ZouQiangBin/POV-LED/POV LED (1).jpg

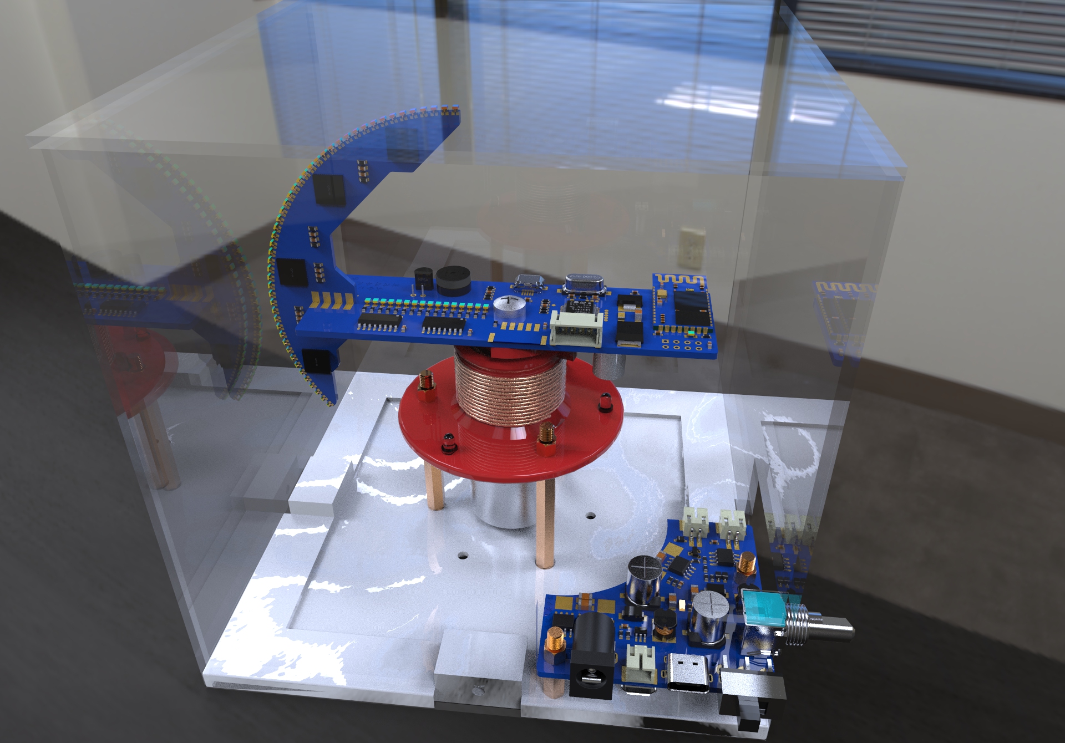
POV LED (1).jpg
