ZouQiangBin/POV-LED/1-DATASHEET/插座-LIGHTING2-苹果.jpg

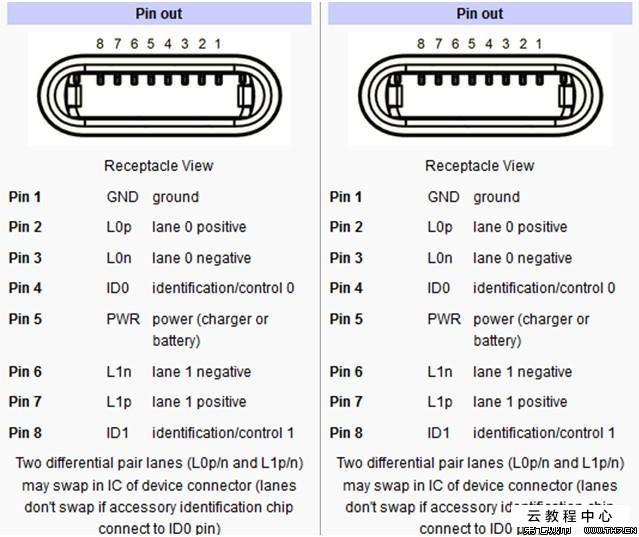
1-DATASHEET/插座-LIGHTING2-苹果.jpg
