ZouQiangBin/POV-LED/README.md

# POV-LED
一个有意思的LED项目
POV LED (1)
