ZouQiangBin/POV-LED/0-SCH&PCB&3D/ReadMe.txt

.sch和.pcb文件请使用PADS VX2.4或更高版本打开，结构文件请用中望3D 2020或更高版本打开
