ZouQiangBin/POV-LED/3-FIRMWARE/Project-MBI5353-SK9822/User/ReadMe.txt

作者：我就是头驴
时间：2022.3.13

整个项目包括：
1.用户IO：保留
2.SPI1、SPI2：LED控制
3.ADC1：采集无线供电电源电压、5V电压
4.USART2：BLE蓝牙串口
5.TIM1：灰度时钟
6.TIM2：速度测量
7.TIM3：蜂鸣器控制
8.TIM4：所有LED刷新
9.贪吃蛇功能
10.图片播放-暂未实现弧形界面纠正
11.音乐播放
