ZouQiangBin/POV-LED/1-DATASHEET/蓝牙模块-ECB02/4.硬件参考资料/ECB01硬件参考设计/说明.txt

ECB01-Kit-001.PcbDoc   贴片天线
ECB01-Kit-002.PcbDoc   PCB天线
ECB01-Kit-003.PcbDoc   IPEX一代天线连接器
ECB01-Kit-004.PcbDoc   IPEX三代天线连接器
ECB01-Kit-005.PcbDoc   SMA天线连接器
