ZouQiangBin/POV-LED/5-论文及资料/基于POV的两类旋转LED屏的研究与实现.pdf

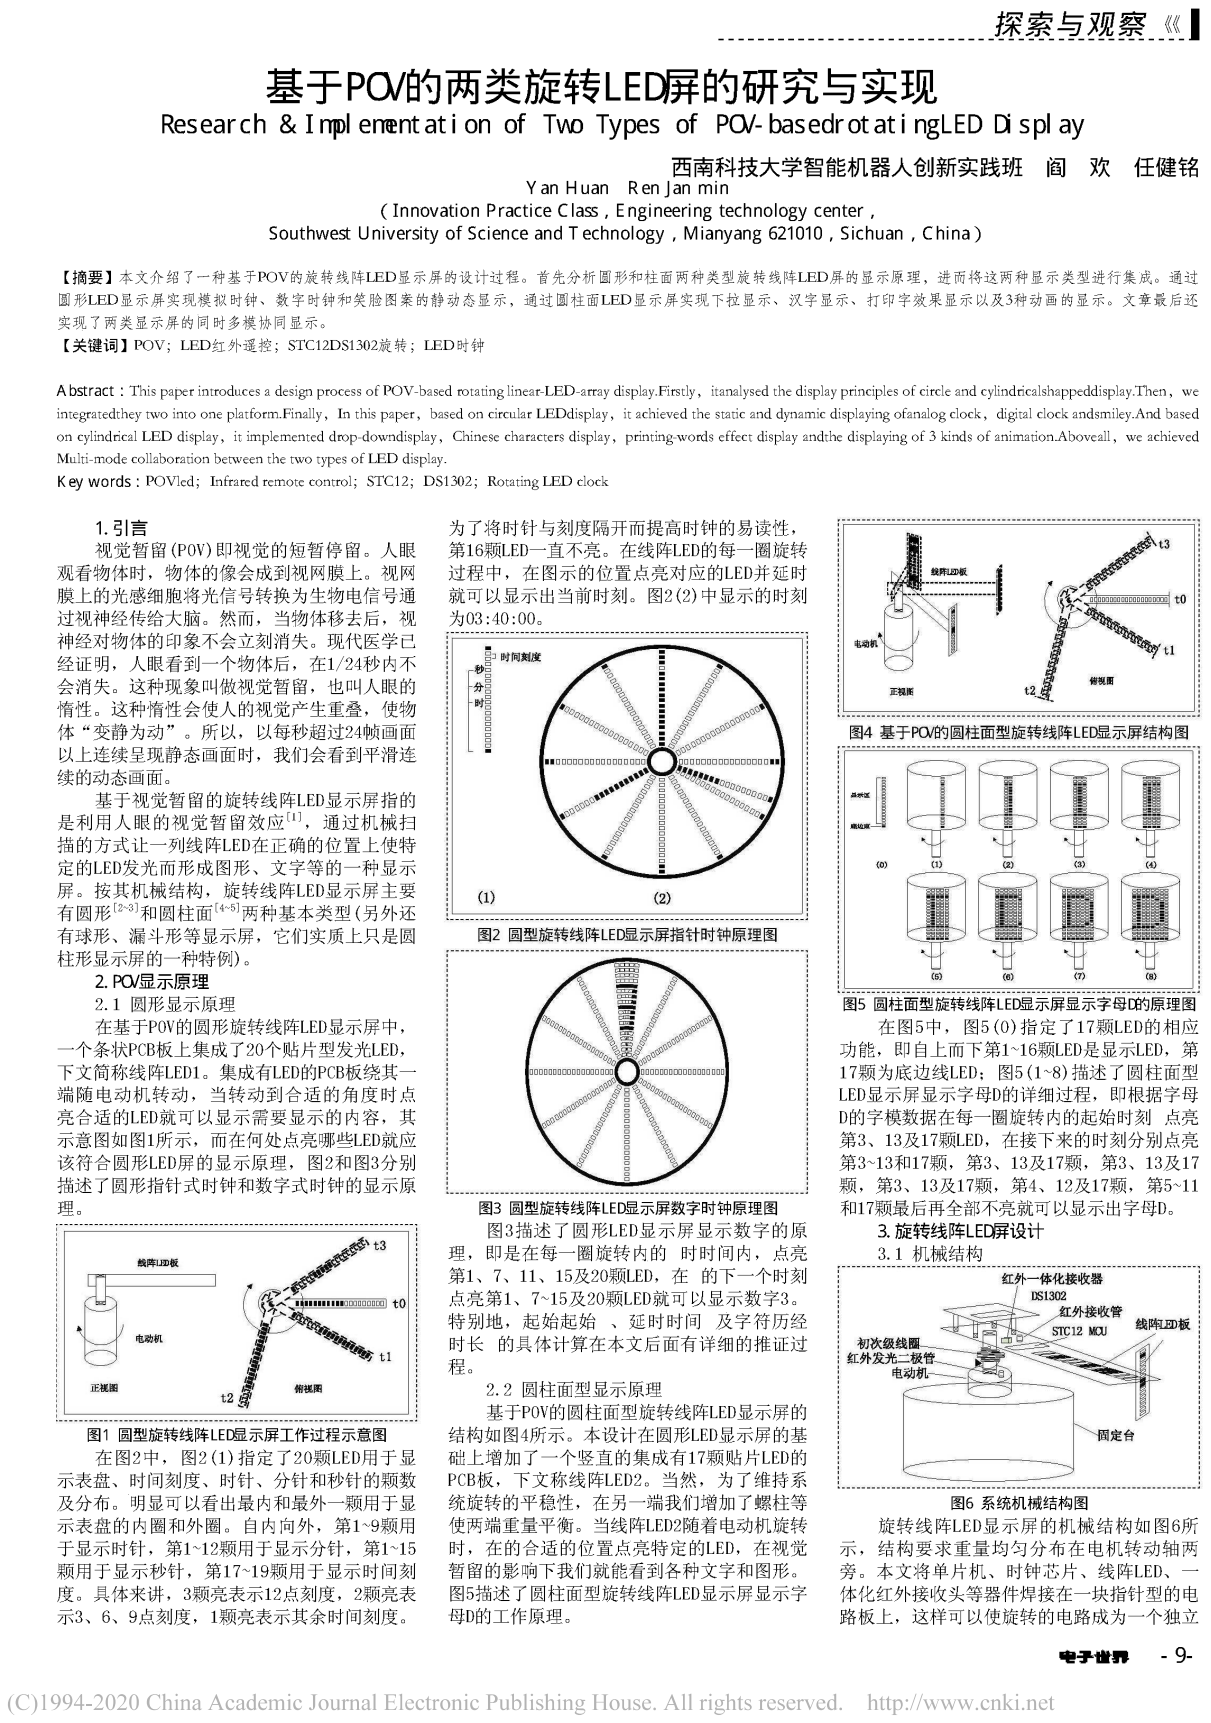
[picture p13: page 1]

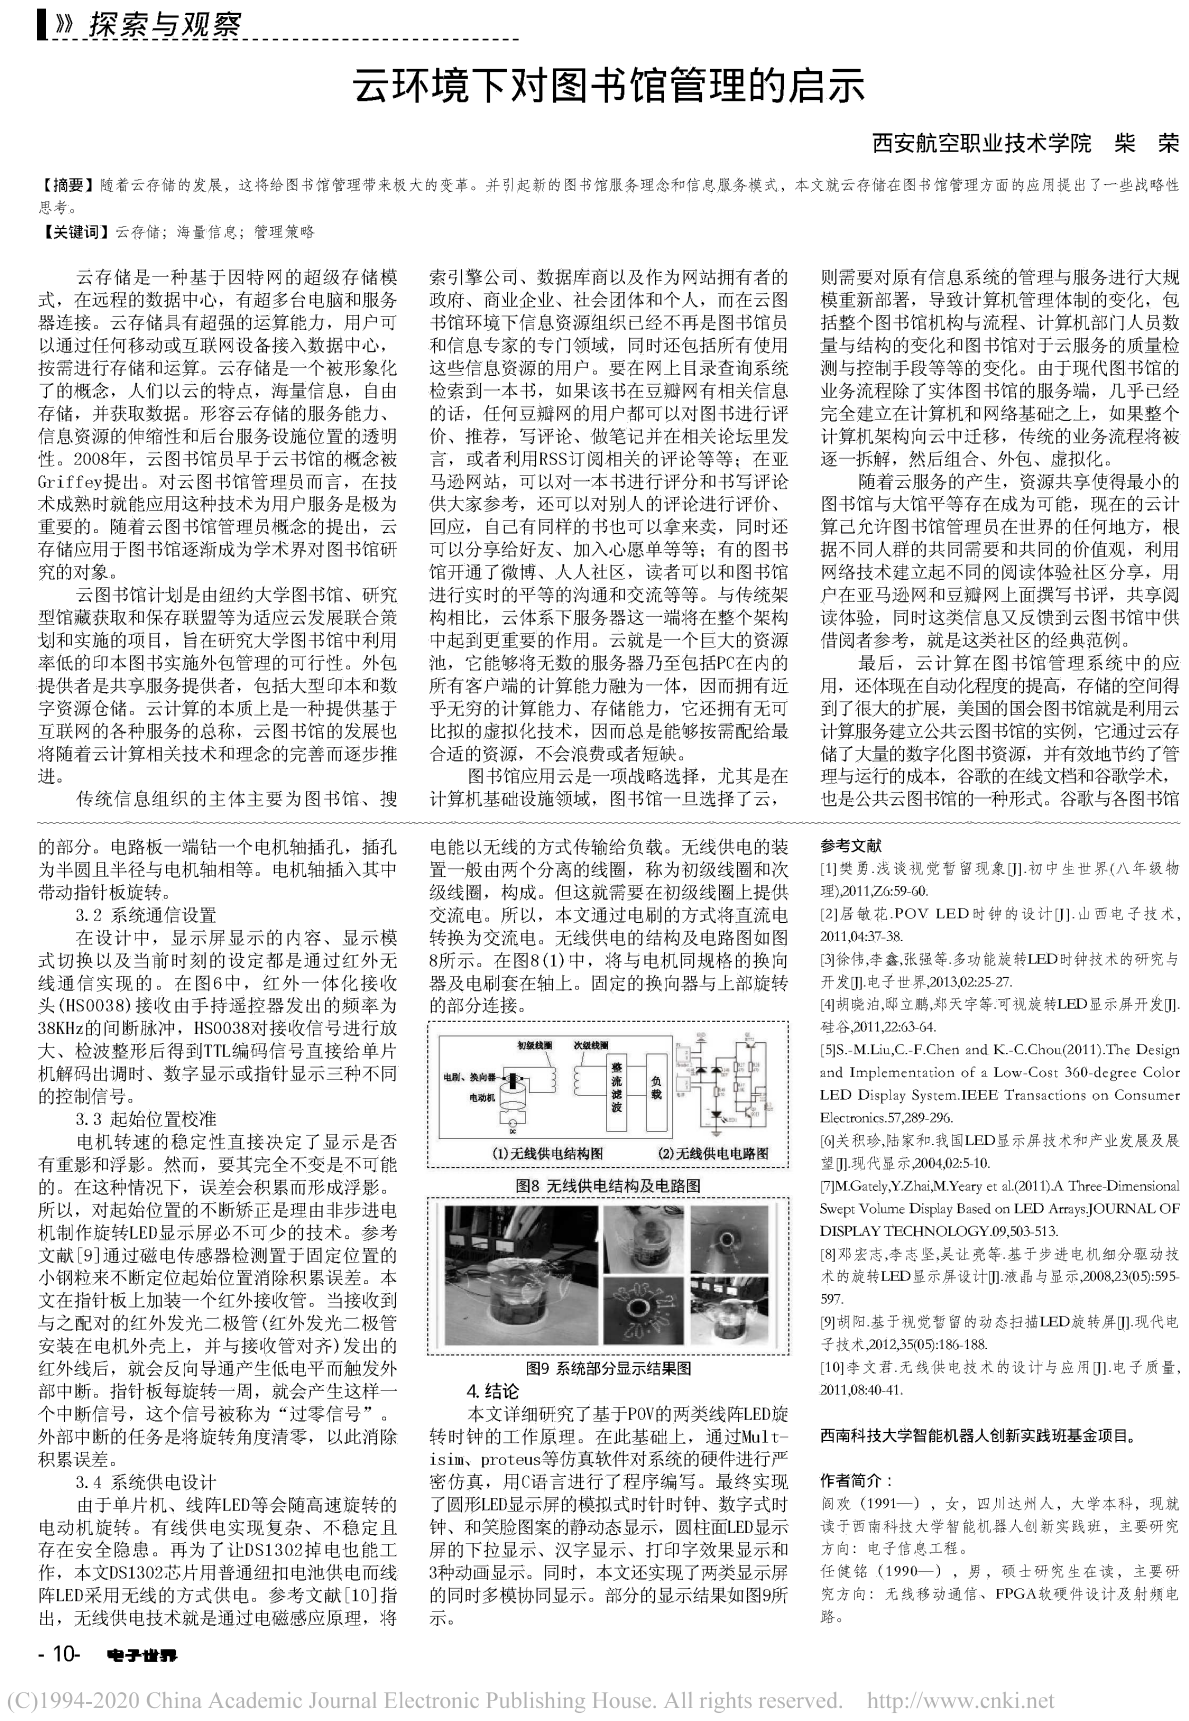
[picture p14: page 2]
