ZouQiangBin/POV-LED/1-DATASHEET/LED灯珠-0603.png

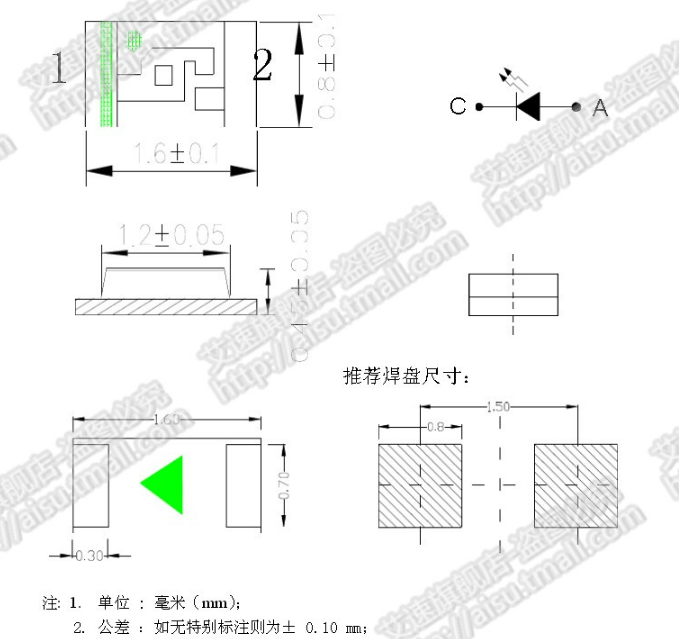
1-DATASHEET/LED灯珠-0603.png
