ZouQiangBin/POV-LED/1-DATASHEET/LED灯珠-0805-RGB-2012封装.PNG

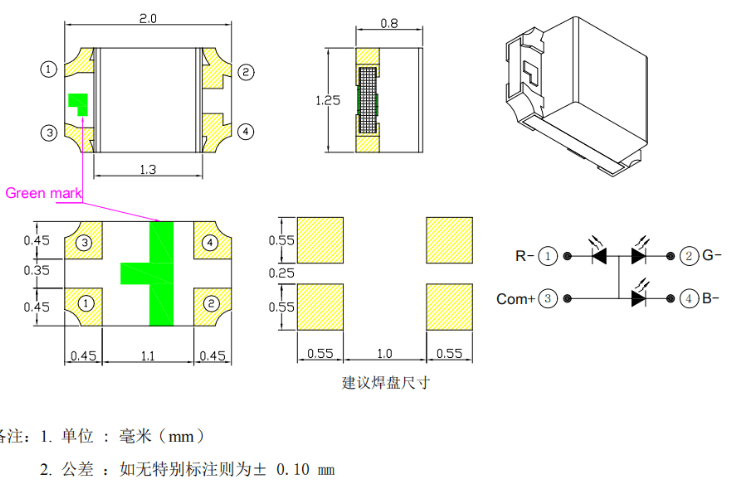
1-DATASHEET/LED灯珠-0805-RGB-2012封装.PNG
