ZouQiangBin/POV-LED/1-DATASHEET/LED灯珠-0805.png

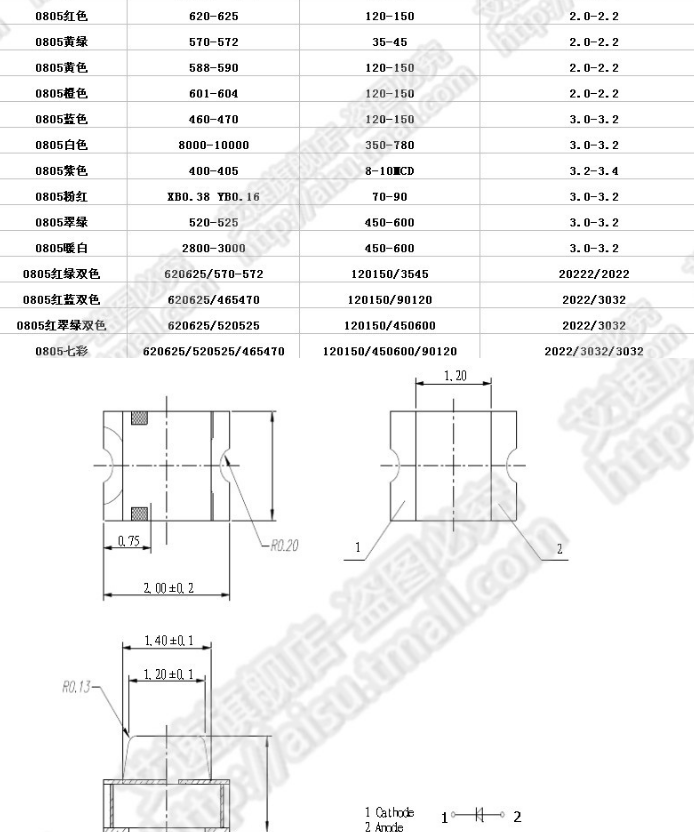
1-DATASHEET/LED灯珠-0805.png
