ZouQiangBin/POV-LED/1-DATASHEET/开关-5x5x1.5-贴片.png

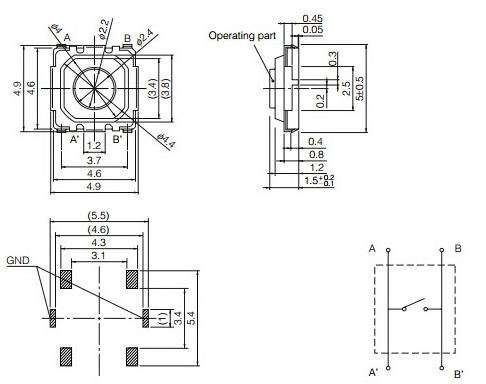
1-DATASHEET/开关-5x5x1.5-贴片.png
