ZouQiangBin/POV-LED/1-DATASHEET/开关-SS12D06.PNG

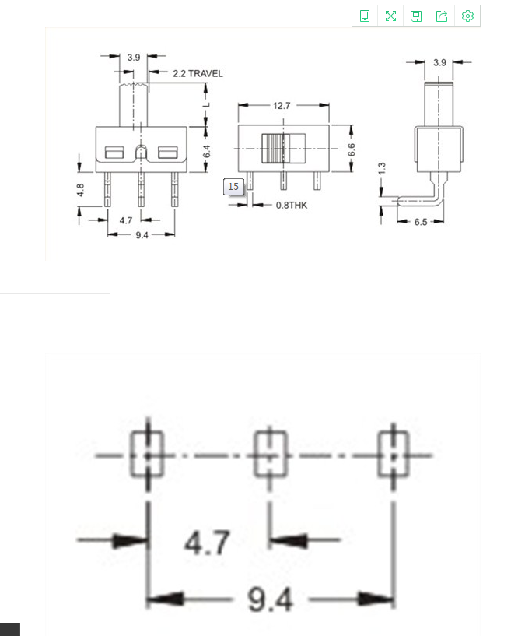
1-DATASHEET/开关-SS12D06.PNG
