ZouQiangBin/POV-LED/1-DATASHEET/插座-DC-005-电源接口.PNG

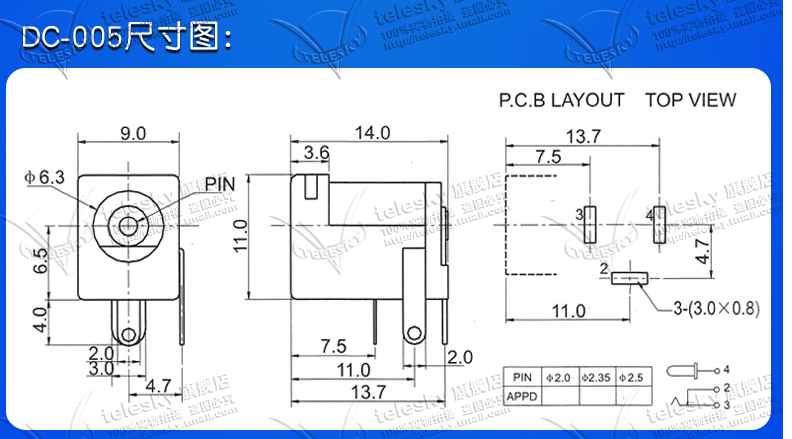
1-DATASHEET/插座-DC-005-电源接口.PNG
