ZouQiangBin/POV-LED/1-DATASHEET/插座-PH2.0卧式贴片.PNG

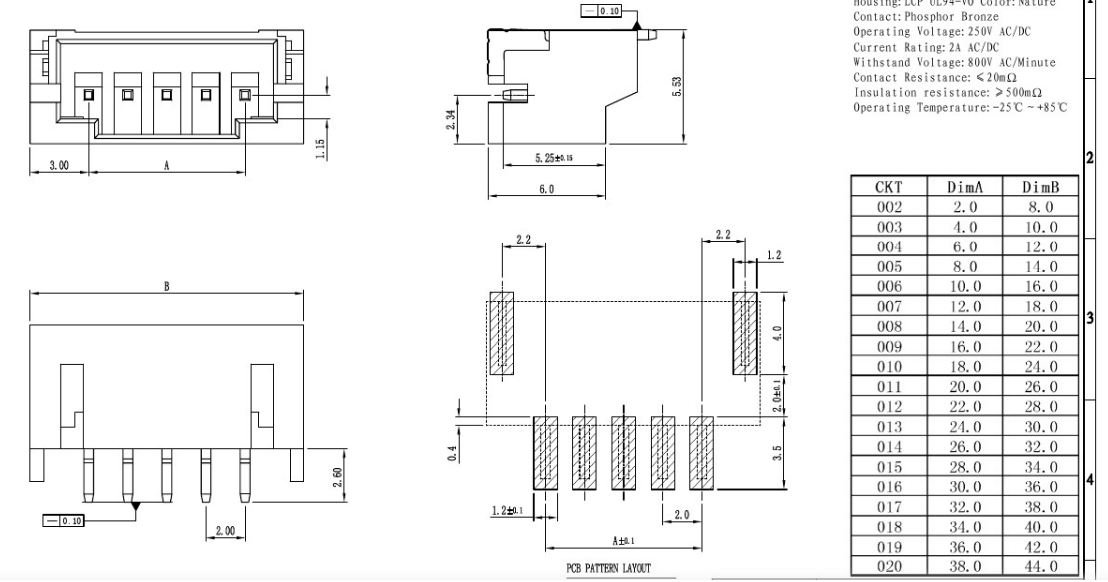
1-DATASHEET/插座-PH2.0卧式贴片.PNG
