ZouQiangBin/POV-LED/1-DATASHEET/插座-USB-TYPEC-6P.PNG

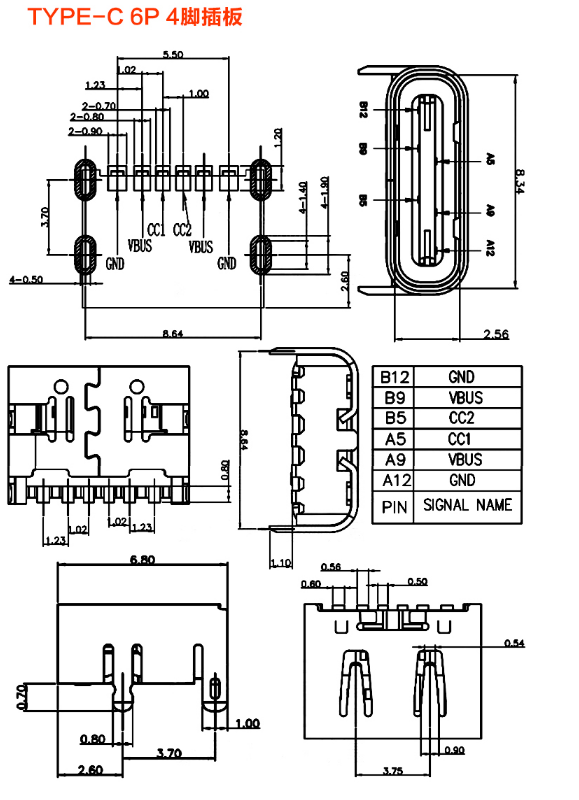
1-DATASHEET/插座-USB-TYPEC-6P.PNG
