ZouQiangBin/POV-LED/1-DATASHEET/插座-USBA-4P-侧插.jpg

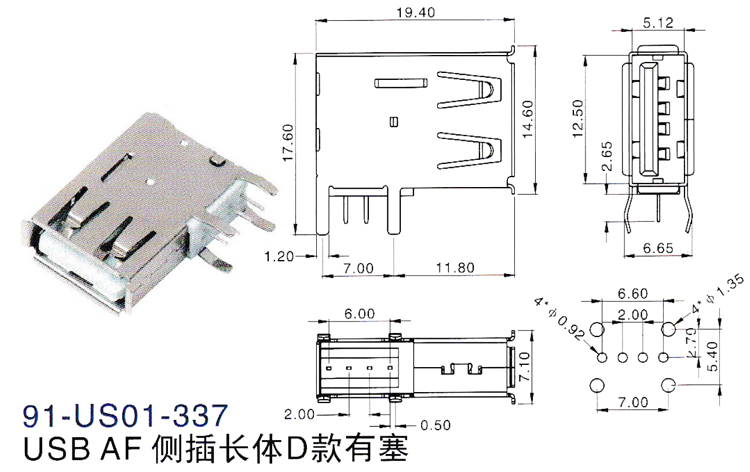
1-DATASHEET/插座-USBA-4P-侧插.jpg
