ZouQiangBin/POV-LED/1-DATASHEET/插座-USBA-4P-带定位孔-贴片.png

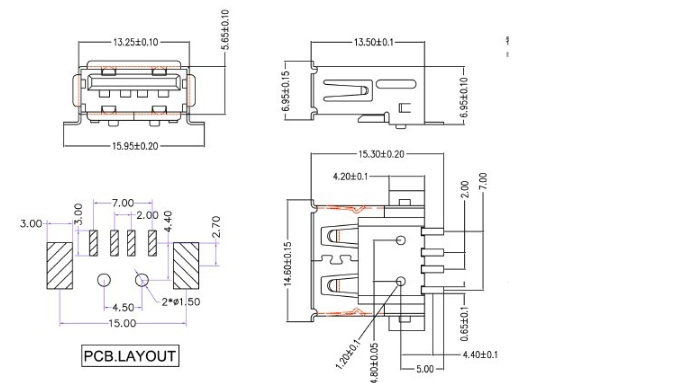
1-DATASHEET/插座-USBA-4P-带定位孔-贴片.png
