ZouQiangBin/POV-LED/1-DATASHEET/晶振-8M-封装.png

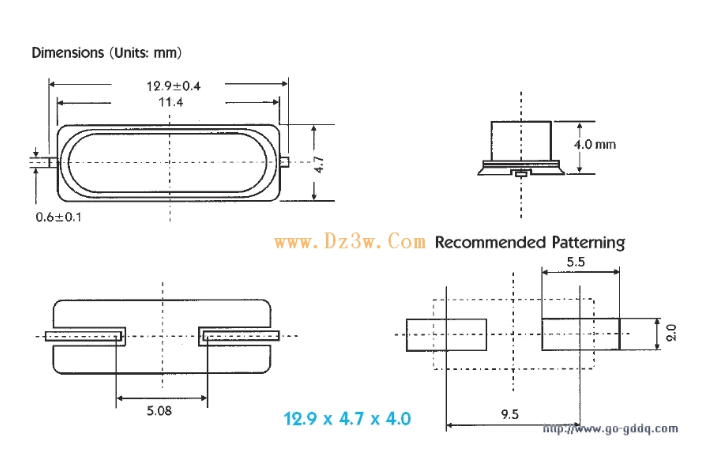
1-DATASHEET/晶振-8M-封装.png
