ZouQiangBin/POV-LED/1-DATASHEET/模块-WIFI-ESP-01S.PNG

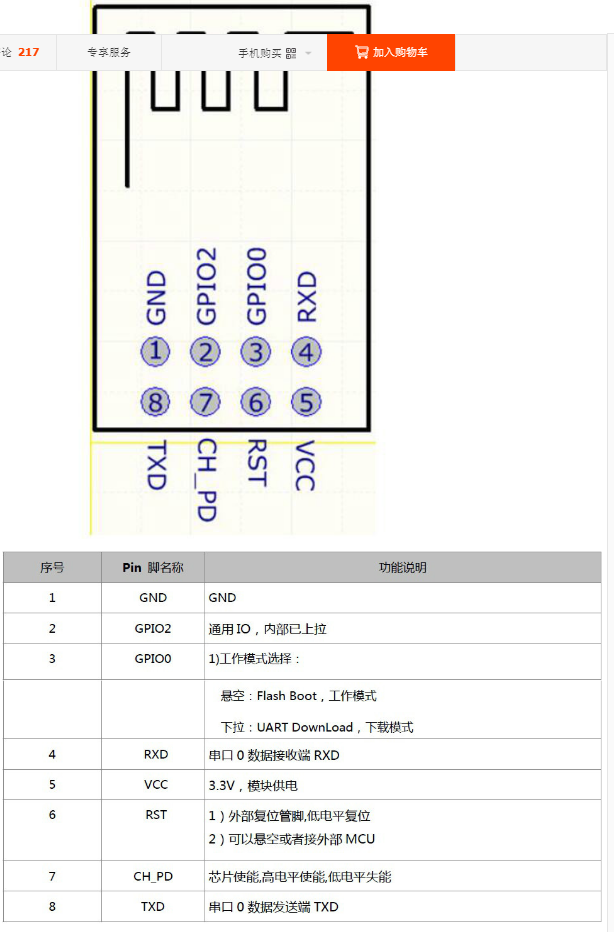
1-DATASHEET/模块-WIFI-ESP-01S.PNG
