ZouQiangBin/POV-LED/1-DATASHEET/蜂鸣器-无源.jpg

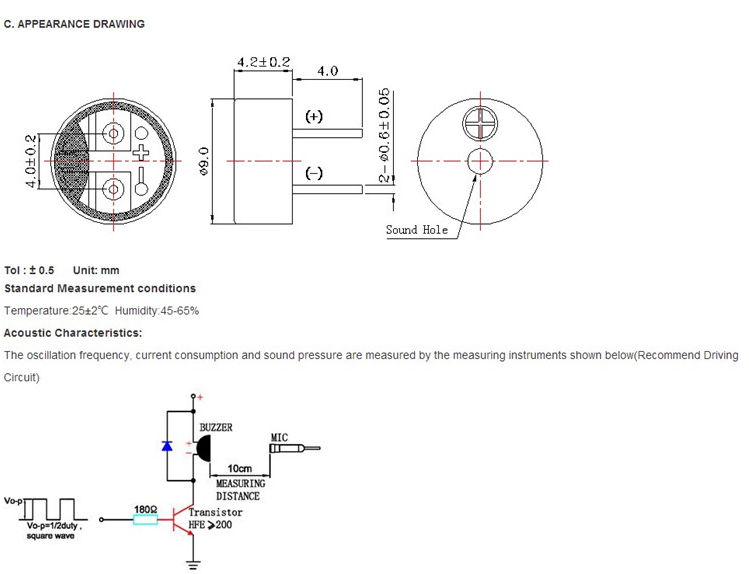
1-DATASHEET/蜂鸣器-无源.jpg
