ZouQiangBin/POV-LED/1-DATASHEET/蜂鸣器-有源.png

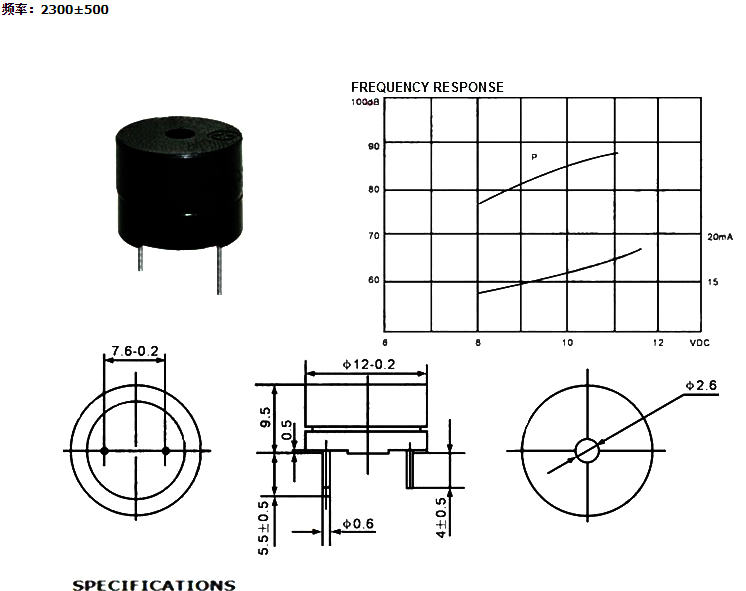
1-DATASHEET/蜂鸣器-有源.png
