ZouQiangBin/POV-LED/1-DATASHEET/贴片电感-CD系列.png

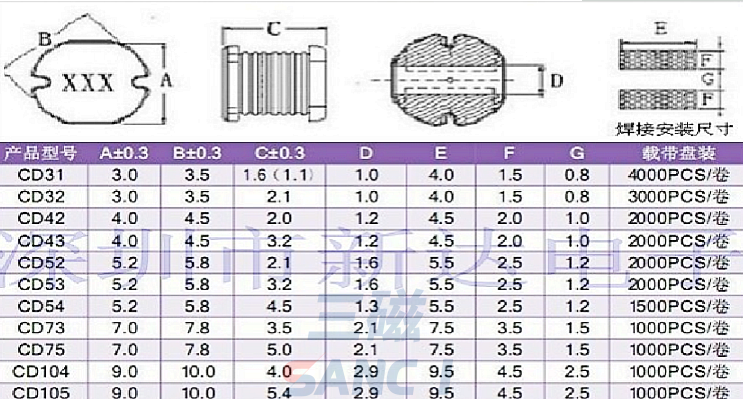
1-DATASHEET/贴片电感-CD系列.png
