ZouQiangBin/POV-LED/POV LED (2).jpg

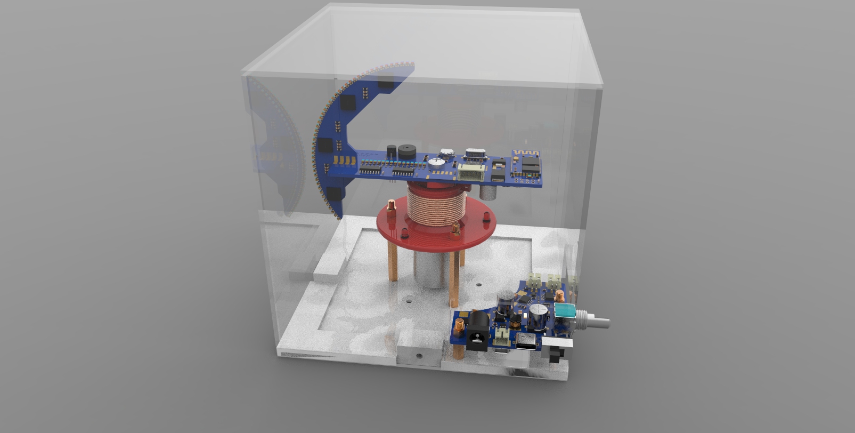
POV LED (2).jpg
