ZouQiangBin/POV-LED/2-BOM/1-LED-A-SCH-MBI5353.xlsx

序号 | 类型 | 规格型号 | 位号 | 数量 | 说明
1 | PCB | LED-A-PCB-MBI5353 |  | 1
2 | 贴片电阻 | R0603,1kΩ | R31,R50 | 2
3 | 贴片电阻 | R0603,3.3kΩ | R24,R27,R28,R30,R32,R34,R35,R36,R37,R39,R41,R42,R43,R44,R45,R48,R51 | 17
4 | 贴片电阻 | R0603,4.7kΩ | R25,R26 | 2 | 保留
5 | 贴片电阻 | R0603,10kΩ(5.1k) | R23 | 1
6 | 贴片电阻 | R0603,6.8kΩ | R22 | 1
7 | 贴片电阻 | R0603,10kΩ | R46,R47,R33,R49,R52,R53,R54,R55 | 8
8 | 贴片电阻 | R0603,44.2kΩ(22.1k) | R21 | 1
9 | 贴片电阻 | R0603,100kΩ | R20,R38,R40 | 3
10 | 贴片电阻 | R0603,1MΩ | R29 | 1
11 | 贴片电容 | C0603,20pF | C33,C37 | 2
12 | 贴片电容 | C0603,3.3nF | C24 | 1
13 | 贴片电容 | C0603,0.01uF | C20,C40 | 2
14 | 贴片电容 | C0603,0.1uF | C17,C26,C28,C29,C30,C31,C34,C35,C36,C38,C41,C42,C43,C44,C45,C46,C47,C48 | 18
15 | 贴片电容 | C0603,1uF | C1,C39 | 2
16 | 贴片电容 | C0603,4.7uF | C32 | 1
17 | 贴片电容 | C1206,68nF,5%,NPO | C21 | 1
18 | 贴片电容 | C1206,22uF,25V | C23,C27 | 2
19 | 电解电容 | SMT,8*10,330uF,25V | C22,C25 | 2
20 | 贴片电感 | CD54,15uH,2A | L20 | 1
21 | 多股绕线电感 | 17mm*15.5mm,29砸,10uH,1.5m | I20 | 1 | 手工绕制
22 | 贴片LED | LED0805 | LED20,LED21,LED22,LED23,LED24,LED25,LED26,LED27,LED28,LED29,LED30,LED31,LED32,LED33,LED34,LED36,LED37 | 17
23 | 红外接收LED | 插件,3mm,940nm,黑色接收 | LED35 | 1
24 | 贴片保险丝 | R1206,6V,2A | F20 | 1 | 保留
25 | 晶振 | SMD-H49,8M | Y20 | 1
26 | 二极管 | SOD323,二极管,1N4148WS | D25,D26,D27 | 3
27 | 二极管 | SMA,肖特基二极管,40V,3A,SS34 | D22 | 1
28 | 二极管 | SMA,肖特基二极管,100V,5A,SS510 | D20,D21,D23,D24 | 4 | 仅焊接D20,D24短接
29 | 三极管 | TO92,S8050(NPN) | Q20 | 1
30 | IC | ESOP8,XKT-3169 | U21 | 1
31 | IC | SOT223,1.0A,MS1117-3.3V | U20 | 1
32 | IC | DPAK,1.5A,LD29150-3.3V | U23 | 1 | 保留
33 | IC | SOP16,74HC595DR2G | U25,U26 | 2
34 | IC | LQFP48,STM32F103C8T6 | U24 | 1
35 | BEEP | 9042,2700Hz,无源蜂鸣器 | BUZZ | 1
36 | 端子 | SMT,PH2.0*4P,母座 | J9 | 1
37 | 端子 | SMT,PH2.0*5P,母座 | J10 | 1 | 保留
38 | 端子 | 插件,2.54*2*4P,母座 | J21 | 1 | 保留
39 | 端子 | MICRO-USB-A | J20 | 1
40 | 模块 | 蓝牙模块,ECB02S3 | U1 | 1
