ZouQiangBin/POV-LED/2-BOM/2-LED-B-SCH-SK9822.xlsx

序号 | 类型 | 规格型号 | 位号 | 数量 | 说明
1 | PCB | LED-B-PCB-SK9822 |  | 1
2 | 贴片电阻 | R0603,10Ω | R1,R3 | 2 | 因手头物料，实际焊接均为100R
3 | 贴片电阻 | R0603,470Ω | R2,R4,R5 | 3
4 | 贴片电容 | C0402,100pF | C41,C42 | 2 | 因手头物料，未焊接
5 | 贴片电容 | C0402,0.1uF | C1-C40 | 40
6 | 贴片LED | 2*2*0.65mm,SK9822-EC20 | LED1-LED40 | 40
7 | IC | SOT23-5,SN74LVC1G08 | U1,U2 | 2 | PCB新版未打样，直接短接1、2脚
