ZouQiangBin/POV-LED/2-BOM/3-LED-C-SCH.xlsx

序号 | 类型 | 规格型号 | 位号 | 数量 | 说明
1 | PCB | LED-C-PCB |  | 1
2 | 贴片电阻 | R0603,100Ω | R7,R10,R14 | 3
3 | 贴片电阻 | R0603,3.3kΩ | R5,R16 | 2
4 | 贴片电阻 | R0603,4.7kΩ | R2,R12,R15,R17 | 4 | R12不焊
5 | 贴片电阻 | R0603,7,5kΩ | R8 | 1 | 不焊
6 | 贴片电阻 | R0603,47kΩ | R6,R9 | 2 | 不焊
7 | 贴片电阻 | R0603,51kΩ | R4,R13 | 2
8 | 贴片电阻 | R0603,75kΩ | R3 | 1
9 | 贴片电阻 | R0603,200kΩ | R1 | 1
10 | 电位器 | RK097N-10MM,可调电阻器,10KΩ | R11 | 1
11 | 贴片电容 | C0603,1nF | C10 | 1 | 不焊
12 | 贴片电容 | C0603,10nF | C15,C16 | 2
13 | 贴片电容 | C0603,0.1uF | C2,C3,C6,C11,C13 | 5
14 | 贴片电容 | C1206,100nF,5%,NPO | C7,C8,C9 | 3 | C8,C9不焊
15 | 贴片电容 | C1206,10uF,25V | C1 | 1
16 | 贴片电容 | C1206,22uF,25V | C12 | 1
17 | 电解电容 | SMT,8*10,330uF,25V | C4,C5 | 2
18 | 贴片电感 | CD54,4.7uH,2A | L1,L2 | 2
19 | 多股绕线电感 | 28mm*15.5mm,15砸,5uH,1.4m | I1 | 1
20 | 多股绕线电感 | 14uH | I2 | 1 | 不焊
21 | 贴片LED | LED0603 | LED1 | 1
22 | 二极管 | SOD323,二极管,1N4148WS | D3,D4,D5 | 3
23 | 二极管 | SMA,肖特基二极管,40V,3A,SS34 | D1,D2 | 2
24 | NMOS管 | SOT23-3,SI2302 | Q1 | 1
25 | IC | ESOP8,XKT-518 | U2 | 1
26 | IC | ESOP8,XKT-412 | U3 | 1 | 不焊
27 | IC | ESOP8,XKT-335 | U4 | 1 | 不焊
28 | IC | SOP8,NE555 | U6 | 1
29 | IC | SOT23-6,SX1308 | U1,U5 | 2
30 | 插座 | DC005-5.5-2.5 | J4 | 1
31 | 插座 | 苹果接口,LIGHTNING-10P | J6 | 1
32 | 插座 | USB-4P-A | J3 | 1
33 | 插座 | USB-6P-C | J1 | 1
34 | 插座 | USB-MICRO | J2 | 1
35 | 插座 | PH2.0_2P | J5,J7,J8 | 3
36 | 开关 | SS12D06-3P | SW1 | 1
