ZouQiangBin/POV-LED/2-BOM/4-结构件.xlsx

序号 | 规格型号 | 数量 | 链接 | 说明
1 | LED-A-PCB | 1
2 | LED-B-PCB | 1
3 | LED-C-PCB | 1
4 | 红外发射管，940nm | 1
5 | PH2.0公头+导线 | 2
6 | 370电机B2，6~12V，轴长17mm，轴径2mm | 1 | B2款高速370电机大扭矩直流6-12V含铜碳刷马达教学模型制作水弹枪-tmall.com天猫 (https://detail.tmall.com/item.htm?id=610070396898&_u=m24vgrccba54&skuId=4465802251195)
7 | 铜质六角联轴器+螺丝，孔径2mm，总长18mm，六角边对边12mm | 1 | 铜质六角联轴器 连轴传动件 电机马达连接器 模型联轴器 车模配件-tmall.com天猫 (https://detail.tmall.com/item.htm?id=592008487948&_u=m24vgrcc9277&skuId=4238770459162)
8 | 铜柱，M3*45+6 | 3 |  | 支撑铜柱尽量短一点，重心低一点
9 | 铜柱，M3*5+6 | 2
10 | 螺帽，M3 | 5
11 | 螺丝，M3*5 | 7
12 | 螺丝，M4*10 | 1
13 | 底板 | 1
14 | 亚克力外壳 | 1
15 | 发射线圈构件 | 1
16 | 接收线圈构件 | 1
