ZouQiangBin/POV-LED/1-DATASHEET/IC-LED驱动-NXPProductSelectorResults.xls

Downloaded on:Sat Sep 11 01:27:41 MST 2021
Visit NXP.com to get the latest specifications for these devices.
DownloadSummary
Resources | Products
Parts | Marketing Description | Use Coupon | Status | Budgetary Price excluding tax(US$) | Package Type | Package Termination Count
ASL1500SHNY | Single-Phase Automotive LED Boost Driver | N | Active | 1K @ US$1.22 | HVQFN32 | 32
ASL1507SHNY | Single-phase boost converter IC , automotive grade, SPI, Limp Home mode | N | Active | 1K @ US$1.32 | HVQFN32 | 32
ASL2416SHNY | Two-channel Automotive LED Buck Driver | N | Active | 1K @ US$1.71 | HVQFN32 | 32
ASL2417SHNY | Two-channel buck mode LED driver IC, Automotive grade, SPI, Limp Home mode | N | Active | 1K @ US$2.05 | HVQFN32 | 32
ASL2500SHNY | Two-Phase Automotive LED Boost Driver | N | Active | 1K @ US$1.32 | HVQFN32 | 32
ASL2507SHNY | Dual phase boost converter IC, Automotive grade, SPI, Limp Home mode | N | Active | 1K @ US$1.43 | HVQFN32 | 32
ASL3416SHNY | Three-channel Automotive LED Buck Driver | N | Active | 1K @ US$1.83 | HVQFN32 | 32
ASL3417SHNY | Three-channel buck mode LED driver IC, Automotive Grade, SPI, Limp Home mode | N | Active | 1K @ US$2.20 | HVQFN32 | 32
ASL4500SHNY | Four-Phase Automotive LED Boost Driver | N | Active | - | HVQFN32 | 32
ASL4501SHNY | Four-phase DC-to-DC boost converter IC, Automotive Grade, SPI, optimized supply voltage | N | Active | - | HVQFN32 | 32
ASL5008FHNZ |  | N | Active | - | HVQFN36 | 36
ASL5008FHV/0Y |  | N | Active | - | HLQFP48 | 48
ASL5008SHNZ |  | N | Active | - | HVQFN36 | 36
ASL5008SHV/0Y |  | N | Active | - | HLQFP48 | 48
ASL5015FHNZ |  | N | Active | - | HVQFN36 | 36
ASL5015FHV/0Y |  | N | Active | - | HLQFP48 | 48
ASL5015SHNZ |  | N | Active | - | HVQFN36 | 36
ASL5015SHV/0Y |  | N | Active | - | HLQFP48 | 48
ASL5108FHNZ |  | N | Active | - | HVQFN36 | 36
ASL5108FHV/0Y |  | N | Active | - | HLQFP48 | 48
ASL5108SHNZ |  | N | Active | - | HVQFN36 | 36
ASL5108SHV/0Y |  | N | Active | - | HLQFP48 | 48
ASL5115FHNZ |  | N | Active | - | HVQFN36 | 36
ASL5115FHV/0Y |  | N | Active | - | HLQFP48 | 48
ASL5115SHNZ |  | N | Active | - | HVQFN36 | 36
ASL5115SHV/0Y |  | N | Active | - | HLQFP48 | 48
MC34844AEP | LED Backlight Driver, 10 Channel with Integrated Power Supply, QFN 32 | N | Active | 1K @ US$1.99 | HVQFN32 | 32
MC34844AEPR2 | LED Backlight Driver, 10 Channel with Integrated Power Supply, QFN 32 | N | Active | 1K @ US$1.99 | HVQFN32 | 32
PCA9530D,112 | I2C 5 V Voltage Source LED Blinker | N | No Longer Manufactured | 1K @ US$0.53 | SO8 | 8
PCA9530D,118 | I2C 5 V Voltage Source LED Blinker | N | Active | 1K @ US$0.53 | SO8 | 8
PCA9530DP,118 | I2C 5 V Voltage Source LED Blinker | N | Active | 1K @ US$0.53 | TSSOP8 | 8
PCA9531BS,118 | I2C 5 V Voltage Source LED Blinker | N | Active | 1K @ US$0.81 | HVQFN16 | 16
PCA9531D,112 | I2C 5 V Voltage Source LED Blinker | N | No Longer Manufactured | 1K @ US$0.81 | SO16 | 16
PCA9531D,118 | I2C 5 V Voltage Source LED Blinker | N | Active | 1K @ US$0.81 | SO16 | 16
PCA9531PW,112 | I2C 5 V Voltage Source LED Blinker | N | No Longer Manufactured | 1K @ US$0.81 | TSSOP16 | 16
PCA9531PW,118 | I2C 5 V Voltage Source LED Blinker | N | Active | 1K @ US$0.81 | TSSOP16 | 16
PCA9532BS,118 | I2C 5 V Voltage Source LED Blinker | N | Active | 1K @ US$0.91 | HVQFN24 | 24
PCA9532D,112 | I2C 5 V Voltage Source LED Blinker | N | No Longer Manufactured | 1K @ US$0.95 | SO24 | 24
PCA9532D,118 | I2C 5 V Voltage Source LED Blinker | N | Active | 1K @ US$0.95 | SO24 | 24
PCA9532PW,112 | I2C 5 V Voltage Source LED Blinker | N | Active | 1K @ US$0.95 | TSSOP24 | 24
PCA9532PW,118 | I2C 5 V Voltage Source LED Blinker | N | Active | 1K @ US$0.95 | TSSOP24 | 24
PCA9532PW/S908,118 | I2C 5 V Voltage Source LED Blinker | N | No Longer Manufactured | 1K @ US$0.95 | TSSOP24 | 24
PCA9533D/01,112 | I2C 5 V Voltage Source LED Blinker | N | No Longer Manufactured | 1K @ US$0.64 | SO8 | 8
PCA9533D/01,118 | I2C 5 V Voltage Source LED Blinker | N | Active | 1K @ US$0.64 | SO8 | 8
PCA9533D/02,112 | I2C 5 V Voltage Source LED Blinker | N | No Longer Manufactured | 1K @ US$0.64 | SO8 | 8
PCA9533D/02,118 | I2C 5 V Voltage Source LED Blinker | N | Active | 1K @ US$0.64 | SO8 | 8
PCA9533DP/01,118 | I2C 5 V Voltage Source LED Blinker | N | Active | 1K @ US$0.64 | TSSOP8 | 8
PCA9533DP/02,118 | I2C 5 V Voltage Source LED Blinker | N | Active | 1K @ US$0.64 | TSSOP8 | 8
PCA9550D,112 | I2C 5 V Voltage Source LED Blinker | N | No Longer Manufactured | 1K @ US$0.64 | SO8 | 8
PCA9550D,118 | I2C 5 V Voltage Source LED Blinker | N | Active | 1K @ US$0.64 | SO8 | 8
PCA9550DP,118 | I2C 5 V Voltage Source LED Blinker | N | Active | 1K @ US$0.64 | TSSOP8 | 8
PCA9551BS,118 | I2C 5 V Voltage Source LED Blinker | N | Active | 1K @ US$0.76 | HVQFN16 | 16
PCA9551BSHP | I2C 5 V Voltage Source LED Blinker | N | No Longer Manufactured | 1K @ US$0.76 | HVQFN16 | 16
PCA9551D,112 | I2C 5 V Voltage Source LED Blinker | N | No Longer Manufactured | 1K @ US$0.75 | SO16 | 16
PCA9551D,118 | I2C 5 V Voltage Source LED Blinker | N | Active | 1K @ US$0.75 | SO16 | 16
PCA9551PW,112 | I2C 5 V Voltage Source LED Blinker | N | No Longer Manufactured | 1K @ US$0.67 | TSSOP16 | 16
PCA9551PW,118 | I2C 5 V Voltage Source LED Blinker | N | Active | 1K @ US$0.67 | TSSOP16 | 16
PCA9551PW/G,118 | I2C 5 V Voltage Source LED Blinker | N | No Longer Manufactured | 1K @ US$0.67 | TSSOP16 | 16
PCA9552BS,118 | I2C 5 V Voltage Source LED Blinker | N | Active | 1K @ US$0.96 | HVQFN24 | 24
PCA9552D,112 | I2C 5 V Voltage Source LED Blinker | N | No Longer Manufactured | 1K @ US$0.95 | SO24 | 24
PCA9552D,118 | I2C 5 V Voltage Source LED Blinker | N | Active | 1K @ US$0.95 | SO24 | 24
PCA9552PW,112 | I2C 5 V Voltage Source LED Blinker | N | No Longer Manufactured | 1K @ US$0.91 | TSSOP24 | 24
PCA9552PW,118 | I2C 5 V Voltage Source LED Blinker | N | Active | 1K @ US$0.91 | TSSOP24 | 24
PCA9552PW/G,118 | I2C 5 V Voltage Source LED Blinker | N | No Longer Manufactured | 1K @ US$0.91 | TSSOP24 | 24
PCA9553DP/01,118 | I2C 5 V Voltage Source LED Blinker | N | Active | 1K @ US$0.62, 1K @ US$0.63 | TSSOP8 | 8
PCA9553DP/02,118 | I2C 5 V Voltage Source LED Blinker | N | Active | 1K @ US$0.62, 1K @ US$0.63 | TSSOP8 | 8
PCA9622DR,118 | I2C 40 V Voltage Source LED Controller | N | Active | 1K @ US$1.12 | TSSOP32 | 32
PCA9624BS,118 | I2C 40 V Voltage Source LED Controller | N | Active | 1K @ US$0.71 | HVQFN24 | 24
PCA9624PW,112 | I2C 40 V Voltage Source LED Controller | N | No Longer Manufactured | 1K @ US$0.67 | TSSOP24 | 24
PCA9624PW,118 | I2C 40 V Voltage Source LED Controller | N | Active | 1K @ US$0.67 | TSSOP24 | 24
PCA9626B,118 | I2C 40 V Voltage Source LED Controller | N | Active | 1K @ US$1.91 | LQFP48 | 48
PCA9632DP1,118 | I2C 5 V Voltage Source LED Controller | N | Active | 1K @ US$0.45 | TSSOP8 | 8
PCA9632DP2,118 | I2C 5 V Voltage Source LED Controller | N | Active | 1K @ US$0.45 | TSSOP10 | 10
PCA9632DP2Z | I2C 5 V Voltage Source LED Controller | N | Development | 1K @ US$0.45 | TSSOP10 | 10
PCA9632TK,118 | I2C 5 V Voltage Source LED Controller | N | Active | 1K @ US$0.45 | HVSON8 | 8
PCA9633DP1,118 | I2C 5 V Voltage Source LED Controller | N | Active | 1K @ US$0.44 | TSSOP8 | 8
PCA9633PW,112 | I2C 5 V Voltage Source LED Controller | N | No Longer Manufactured | 1K @ US$0.44 | TSSOP16 | 16
PCA9633PW,118 | I2C 5 V Voltage Source LED Controller | N | Active | 1K @ US$0.44 | TSSOP16 | 16
PCA9633TK,118 | I2C 5 V Voltage Source LED Controller | N | Active | 1K @ US$0.44 | HVSON8 | 8
PCA9634BS,118 | I2C 5 V Voltage Source LED Controller | N | Active | 1K @ US$0.67 | HVQFN20 | 20
PCA9634D,112 | I2C 5 V Voltage Source LED Controller | N | No Longer Manufactured | 1K @ US$0.55 | SO20 | 20
PCA9634D,118 | I2C 5 V Voltage Source LED Controller | N | Active | 1K @ US$0.55 | SO20 | 20
PCA9634PW,112 | I2C 5 V Voltage Source LED Controller | N | No Longer Manufactured | 1K @ US$0.56 | TSSOP20 | 20
PCA9634PW,118 | I2C 5 V Voltage Source LED Controller | N | Active | 1K @ US$0.56 | TSSOP20 | 20
PCA9634PW/S910,118 | I2C 5 V Voltage Source LED Controller | N | No Longer Manufactured | 1K @ US$0.56 | TSSOP20 | 20
PCA9635PW,112 | I2C 5 V Voltage Source LED Controller | N | No Longer Manufactured | 1K @ US$0.90 | TSSOP28 | 28
PCA9635PW,118 | I2C 5 V Voltage Source LED Controller | N | Active | 1K @ US$0.90 | TSSOP28 | 28
PCA9635PW/Q900,118 | I2C 5 V Voltage Source LED Controller | N | Active | 1K @ US$0.90 | TSSOP28 | 28
PCA9685BS,118 | I2C 5 V Voltage Source LED Controller | N | Active | 1K @ US$0.90 | HVQFN28 | 28
PCA9685PW,112 | I2C 5 V Voltage Source LED Controller | N | Active | 1K @ US$0.90 | TSSOP28 | 28
PCA9685PW,118 | I2C 5 V Voltage Source LED Controller | N | Active | 1K @ US$0.90 | TSSOP28 | 28
PCA9685PW/Q900,118 | I2C 5 V Voltage Source LED Controller | N | Active | 1K @ US$0.90 | TSSOP28 | 28
PCA9745BTWJ | I2C 20 V Constant Current LED Controller | N | Active | 1K @ US$1.02 | HTSSOP28 | 28
PCA9745BTW/Q900J | I2C 20 V Constant Current LED Controller | N | Active | 1K @ US$1.02 | HTSSOP28 | 28
PCA9952TW,118 | I2C 20 V Constant Current LED Controller | N | No Longer Manufactured | 1K @ US$1.23 | HTSSOP28 | 28
PCA9952TW/Q900,118 | I2C 20 V Constant Current LED Controller | N | Active | 1K @ US$1.23 | HTSSOP28 | 28
PCA9955BTWJ | I2C 20 V Constant Current LED Controller | N | Active | 1K @ US$1.11 | HTSSOP28 | 28
PCA9955BTW/Q900J | I2C 20 V Constant Current LED Controller | N | Active | 1K @ US$1.11 | HTSSOP28 | 28
PCA9955TW,118 | I2C 20 V Constant Current LED Controller | N | No Longer Manufactured | 1K @ US$1.23 | HTSSOP28 | 28
PCA9955TW/Q900,118 | I2C 20 V Constant Current LED Controller | N | Active | 1K @ US$1.23 | HTSSOP28 | 28
PCA9956BTWY | I2C 20 V Constant Current LED Controller | N | Active | 1K @ US$1.11 | HTSSOP38 | 38
PCA9957HNMP | I2C 5 V Constant Current LED Controller | N | Active | - | HVQFN40 | 40
PCA9959HNMP | I2C 5 V Constant Current LED Controller | N | Active | 1K @ US$0.77 | HVQFN40 | 40
PCU9656B,118 | I2C 40 V Voltage Source LED Controller | N | Active | 1K @ US$1.94 | LQFP48 | 48
UBA2014T/N1,118 | 600 V driver IC for HF fluorescent lamps | N | No Longer Manufactured | 10K @ US$0.64 | SO16 | 16
UBA2014T/N1,518 | 600 V driver IC for HF fluorescent lamps | N | Active | 10K @ US$0.64 | SO16 | 16
UBA2021T/N2,112 | 630 V driver IC for CFL and TL lamps | N | No Longer Manufactured | 10K @ US$0.56 | SO14 | 14
UBA2021T/N2,118 | 630 V driver IC for CFL and TL lamps | N | No Longer Manufactured | 10K @ US$0.56 | SO14 | 14
UBA2021T/N2,512 | 630 V driver IC for CFL and TL lamps | N | Active | 10K @ US$0.56 | SO14 | 14
UBA2021T/N2,518 | 630 V driver IC for CFL and TL lamps | N | Active | 10K @ US$0.56 | SO14 | 14
PCA9633DP2,118 | I2C 5 V Voltage Source LED Controller | N | Not Recommended for New Designs | 1K @ US$0.44 | TSSOP10 | 10
UBA2036TS/N1,118 | Full-bridge controller IC for HID automotive lighting | N | End of Life | 10K @ US$1.24 | SSOP28 | 28
MC34845CEP | LED Backlight Driver, 6 Channel with Integrated Power Supply,QFN 24 | N | No Longer Manufactured | 1K @ US$1.41 | HUQFN24 | 24
MC34845CEPR2 | LED Backlight Driver, 6 Channel with Integrated Power Supply,QFN 24 | N | No Longer Manufactured | 1K @ US$1.41 | HUQFN24 | 24
MC34845DEP | LED Backlight Driver, 6 Channel with Integrated Power Supply,QFN 24 | N | No Longer Manufactured | 1K @ US$1.41 | HUQFN24 | 24
MC34845DEPR2 | LED Backlight Driver, 6 Channel with Integrated Power Supply,QFN 24 | N | No Longer Manufactured | 1K @ US$1.41 | HUQFN24 | 24
PCA9901DP,118 | One wire single LED driver | N | No Longer Manufactured | @ $ | TSSOP8 | 8
PCA9901UK,027 | One wire single LED driver | N | No Longer Manufactured | @ $
PCA9922BS,118 | 8-channel constant current LED driver with output error detection | N | No Longer Manufactured | @ $
PCA9922N,112 | 8-channel constant current LED driver with output error detection | N | No Longer Manufactured | @ $
PCA9922PW,112 | 8-channel constant current LED driver with output error detection | N | No Longer Manufactured | @ $ | TSSOP16 | 16
PCA9922PW,118 | 8-channel constant current LED driver with output error detection | N | No Longer Manufactured | @ $ | TSSOP16 | 16
UBA2015T/1,118 | HF-TL controller IC with PFC | N | No Longer Manufactured | 10K @ US$0.72 | SO20 | 20
UBA2015T/1Y | HF-TL controller IC with PFC | N | No Longer Manufactured | 10K @ US$0.72 | SO20 | 20
UBA2017T/1,518 | HF-TL controller IC | N | No Longer Manufactured | @ $ | SO16 | 16
UBA2211AT/N1,518 | Non-dimmable driver IC for CFL | N | No Longer Manufactured | 10K @ US$0.51 | SO14 | 14
UBA2211BT/N1,518 | Non-dimmable driver IC for CFL | N | No Longer Manufactured | 10K @ US$0.56 | SO14 | 14
UBA2211CT/N1,518 | Non-dimmable driver IC for CFL | N | No Longer Manufactured | 10K @ US$0.62 | SO14 | 14
UBA2213AT/N1,518 | Non-dimmable driver IC for CFL with boost | N | No Longer Manufactured | @ $ | SO14 | 14
UBA2213BT/N1,518 | Non-dimmable driver IC for CFL with boost | N | No Longer Manufactured | @ $ | SO14 | 14
UBA2213CT/N1,518 | Non-dimmable driver IC for CFL with boost | N | No Longer Manufactured | @ $ | SO14 | 14
© 2006-2016 NXP Semiconductors. All rights reserved.
