ZouQiangBin/POV-LED/1-DATASHEET/IC-LED驱动-列表.xlsx

厂家 | 型号 | 通信方式 (I2C不考虑) | 通道数 | 最大电流
TI | TLC5955 | spi | 48+RGB | 24mA,MC=5 32mA,MC=7
NXP | PCA9957 | spi | 24+RGB | 32mA
ST | LED2472G | spi | 24+RGB | 72mA
ST | STP24DP05 | spi | 24+RGB | 80mA
台湾聚积 | MBI5353 | SPI | 48+RGB
台湾聚积 | MBI5368 | SPI | 24+RGB
 | DM163 | SPI | 24+RGB
