ZouQiangBin/POV-LED/1-DATASHEET/蓝牙模块-ECB02/4.硬件参考资料/ECB02S2硬件参考设计/logo.DXF

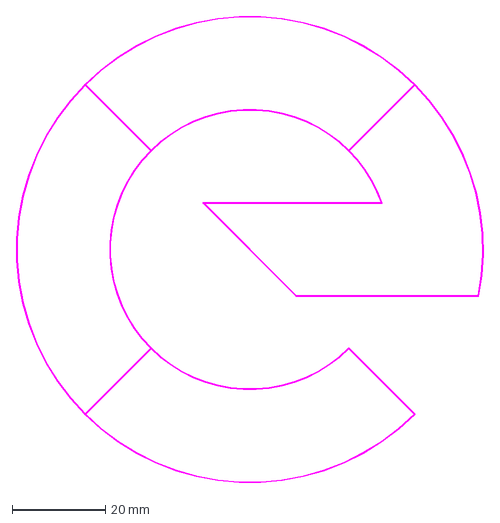
[picture p33: CAD file, 2022-04-04]
1-DATASHEET/蓝牙模块-ECB02/4.硬件参考资料/ECB02S2硬件参考设计/logo.DXF
100.2 x 100.2 mm
