ZouQiangBin/POV-LED/(list of files, drawings)

Other design files:
0-SCH&PCB&3D/LED-A-PCB-IS31FL3236.pcb
0-SCH&PCB&3D/LED-A-PCB-MBI5353.pcb
0-SCH&PCB&3D/LED-B-PCB-IS31FL3236.pcb
0-SCH&PCB&3D/LED-B-PCB-MBI5353.pcb
0-SCH&PCB&3D/LED-B-PCB-SK9822.pcb
0-SCH&PCB&3D/LED-B-PCB-TLC5955.pcb
0-SCH&PCB&3D/LED-C-PCB-备选方案.pcb
0-SCH&PCB&3D/LED-C-PCB.pcb
1-DATASHEET/蓝牙模块-ECB02/4.硬件参考资料/ECB01硬件参考设计/ECB01-Kit-001.PcbDoc
1-DATASHEET/蓝牙模块-ECB02/4.硬件参考资料/ECB01硬件参考设计/ECB01-Kit-002.PcbDoc
1-DATASHEET/蓝牙模块-ECB02/4.硬件参考资料/ECB01硬件参考设计/ECB01-Kit-003.PcbDoc
1-DATASHEET/蓝牙模块-ECB02/4.硬件参考资料/ECB01硬件参考设计/ECB01-Kit-004.PcbDoc
1-DATASHEET/蓝牙模块-ECB02/4.硬件参考资料/ECB01硬件参考设计/ECB01-Kit-005.PcbDoc
1-DATASHEET/蓝牙模块-ECB02/4.硬件参考资料/ECB01硬件参考设计/ECB01-Kit-V1.0.PcbLib
1-DATASHEET/蓝牙模块-ECB02/4.硬件参考资料/ECB01硬件参考设计/ECB01-Kit-V1.0.SchDoc
1-DATASHEET/蓝牙模块-ECB02/4.硬件参考资料/ECB01硬件参考设计/ECB01-Kit-V1.0.SchLib
1-DATASHEET/蓝牙模块-ECB02/4.硬件参考资料/ECB02S2硬件参考设计/ECB02S2-Kit-V1.0.PcbDoc
1-DATASHEET/蓝牙模块-ECB02/4.硬件参考资料/ECB02S2硬件参考设计/ECB02S2-Kit-V1.0.PrjPCB
1-DATASHEET/蓝牙模块-ECB02/4.硬件参考资料/ECB02S2硬件参考设计/ECB02S2-Kit-V1.0.SchDoc
1-DATASHEET/蓝牙模块-ECB02/4.硬件参考资料/ECB02S2硬件参考设计/ECB02蓝牙模块原理图库.SchLib
1-DATASHEET/蓝牙模块-ECB02/4.硬件参考资料/ECB02S2硬件参考设计/ECB02蓝牙模块封装库.PcbLib
1-DATASHEET/蓝牙模块-ECB02/4.硬件参考资料/ECB02硬件参考设计/ECB02-Kit-V1.0.PcbDoc
1-DATASHEET/蓝牙模块-ECB02/4.硬件参考资料/ECB02硬件参考设计/ECB02-Kit-V1.0.PrjPCB
1-DATASHEET/蓝牙模块-ECB02/4.硬件参考资料/ECB02硬件参考设计/ECB02-Kit-V1.0.SchDoc
1-DATASHEET/蓝牙模块-ECB02/4.硬件参考资料/ECB02硬件参考设计/ECB02蓝牙模块原理图库.SchLib
1-DATASHEET/蓝牙模块-ECB02/4.硬件参考资料/ECB02硬件参考设计/ECB02蓝牙模块封装库.PcbLib
1-DATASHEET/蓝牙模块-ECB02/4.硬件参考资料/蓝牙PCB天线库/eciot-2.4G-PCB-ANT.PcbDoc
1-DATASHEET/蓝牙模块-ECB02/4.硬件参考资料/蓝牙PCB天线库/eciot-2.4G-PCB-ANT.PcbLib
1-DATASHEET/蓝牙模块-ECB02/4.硬件参考资料/蓝牙PCB天线库/eciot-2.4G-PCB-ANT.PrjPCB
