ZouQiangBin/POV-LED/3-FIRMWARE/Project-MBI5353-SK9822/User/InterfaceCfg/ASCII.c

#include "ASCII.h"

/***************************************************************************************************/
/*  (0)  !(1)  "(2)  #(3)  $(4)  %(5)  &(6)  '(7)  ((8)  )(9)  *(10) +(11) ,(12) -(13) .(14) /(15) */
/* 0(16) 1(17) 2(18) 3(19) 4(20) 5(21) 6(22) 7(23) 8(24) 9(25) :(26) ;(27) <(28) =(29) >(30) ?(31) */
/* @(32) A(33) B(34) C(35) D(36) E(37) F(38) G(39) H(40) I(41) J(42) K(43) L(44) M(45) N(46) O(47) */
/* P(48) Q(49) R(50) S(51) T(52) U(53) V(54) W(55) X(56) Y(57) Z(58) [(59) \(60) ](61) ^(62) _(63) */
/* `(64) a(65) b(66) c(67) d(68) e(69) f(70) g(71) h(72) i(73) j(74) k(75) l(76) m(77) n(78) o(79) */
/* p(80) q(81) r(82) s(83) t(84) u(85) v(86) w(87) x(88) y(89) z(90) {(91) |(92) }(93) ~(94)       */
/***************************************************************************************************/

const Uint8 ASCII_Code[][16] =
{	
		{0x00,0x00,0x00,0x00,0x00,0x00,0x00,0x00,0x00,0x00,0x00,0x00,0x00,0x00,0x00,0x00},		/*" ",0	*/
		{0x00,0x00,0x00,0x00,0x00,0x00,0x07,0xFC,0x07,0xC4,0x00,0x00,0x00,0x00,0x00,0x00},		/*"!",1	*/
		{0x00,0x00,0x00,0x00,0x03,0x00,0x02,0x00,0x02,0x00,0x03,0x00,0x00,0x00,0x00,0x00},		/*""",2	*/
		{0x00,0x90,0x00,0x9C,0x03,0xF0,0x00,0x90,0x00,0x9C,0x03,0xF0,0x00,0x90,0x00,0x90},		/*"#",3	*/
		{0x00,0x00,0x03,0x98,0x02,0x8C,0x07,0xFE,0x02,0x44,0x03,0x3C,0x01,0x18,0x00,0x00},		/*"$",4	*/
		{0x01,0x80,0x02,0x44,0x03,0xD8,0x00,0xE0,0x00,0xB8,0x03,0x24,0x00,0x3C,0x00,0x00},		/*"%",5	*/
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
		{0x1C,0x80,0x22,0x40,0x22,0x40,0x24,0x80,0x1F,0x00,0x00,0x00},/*"9",25*/
		{0x00,0x00,0x00,0x00,0x08,0x40,0x00,0x00,0x00,0x00,0x00,0x00},/*":",26*/
		{0x00,0x00,0x00,0x00,0x04,0x60,0x00,0x00,0x00,0x00,0x00,0x00},/*";",27*/
		{0x00,0x00,0x06,0x00,0x09,0x00,0x10,0x80,0x20,0x40,0x00,0x00},/*"<",28*/
		{0x0A,0x00,0x0A,0x00,0x0A,0x00,0x0A,0x00,0x0A,0x00,0x0A,0x00},/*"=",29*/
		{0x00,0x00,0x20,0x40,0x10,0x80,0x09,0x00,0x06,0x00,0x00,0x00},/*">",30*/
		{0x18,0x00,0x20,0x00,0x23,0x40,0x24,0x00,0x18,0x00,0x00,0x00},/*"?",31*/
		{0x0F,0x00,0x10,0x80,0x27,0x40,0x2F,0x40,0x21,0x40,0x1E,0x80},/*"@",32*/
		{0x00,0x40,0x07,0xC0,0x39,0x00,0x0F,0x00,0x01,0xC0,0x00,0x40},/*"A",33*/
		{0x20,0x40,0x3F,0xC0,0x24,0x40,0x24,0x40,0x1B,0x80,0x00,0x00},/*"B",34*/
		{0x1F,0x80,0x20,0x40,0x20,0x40,0x20,0x40,0x30,0x80,0x00,0x00},/*"C",35*/
		{0x20,0x40,0x3F,0xC0,0x20,0x40,0x20,0x40,0x1F,0x80,0x00,0x00},/*"D",36*/
		{0x20,0x40,0x3F,0xC0,0x24,0x40,0x2E,0x40,0x30,0xC0,0x00,0x00},/*"E",37*/
		{0x20,0x40,0x3F,0xC0,0x24,0x40,0x2E,0x00,0x30,0x00,0x00,0x00},/*"F",38*/
		{0x0F,0x00,0x10,0x80,0x20,0x40,0x22,0x40,0x33,0x80,0x02,0x00},/*"G",39*/
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
};
