ZouQiangBin/POV-LED/3-FIRMWARE/Project-MBI5353-SK9822/User/InterfaceCfg/PICTURE1.c

#include "main.h"


const Uint8 Pic1[RMAXX][RMAXY*3] = {
#if (DEVICE_SEL == 1)
0X60,0X74,0X70,0XEA,0XEE,0XF3,0XEA,0XEF,0XF2,0XEF,0XE3,0XEF,0XF3,0XE6,0XF1,0XEF,
0XEC,0XF3,0XE8,0XF2,0XF6,0XD3,0XE6,0XEC,0XC8,0XD7,0XDF,0XC5,0XC7,0XD5,0XC3,0XC7,
0XD2,0XB5,0XC0,0XCE,0XD3,0XED,0XF1,0XD6,0XEE,0XF1,0XD9,0XEE,0XF2,0XCF,0XEC,0XF0,
0XD2,0XEA,0XED,0XA8,0XD6,0XDE,0X60,0X63,0X4E,0X8A,0X8F,0X73,0X8C,0X8D,0X73,0X83,
0X84,0X6A,0X25,0X1C,0X12,0X0E,0X08,0X07,0X0C,0X07,0X06,0X13,0X0D,0X0B,0X0E,0X08,
0X08,0X10,0X09,0X09,0X6C,0X53,0X49,0XDB,0XC4,0XB5,0XBF,0X97,0X8F,0X4E,0X40,0X33,
0X2B,0X20,0X1A,0X29,0X20,0X1A,0X92,0X80,0X6E,0XAA,0X9E,0X89,0X96,0X93,0X7A,0X9D,
0X9A,0X81,0X8F,0X90,0X7C,0X9C,0X9C,0X8C,0X96,0X95,0X81,0X97,0X94,0X7F,0X98,0X8D,
0X77,0X90,0X95,0X79,0X89,0X8A,0X76,0X8F,0X80,0X6F,0X86,0X86,0X75,0X74,0X75,0X5E,
0X5B,0X6F,0X67,0XE8,0XF0,0XF1,0XEC,0XE2,0XEC,0XF2,0XE3,0XF0,0XF0,0XE7,0XF1,0XDD,
0XF0,0XF5,0XC0,0XE2,0XE6,0XBE,0XD3,0XDA,0XC0,0XCD,0XD4,0XBC,0XCF,0XD6,0XB2,0XC4,
0XC4,0XD9,0XEF,0XF3,0XD9,0XEF,0XF3,0XDA,0XF0,0XF3,0XDD,0XF1,0XF2,0XD9,0XEE,0XF2,
0XF0,0XEC,0XF3,0XDB,0XE1,0XE9,0XD2,0XE5,0XEB,0XA8,0XAB,0XA8,0XC0,0XC9,0XD2,0XA2,
0XA6,0XAF,0X83,0X7E,0X78,0XC5,0XD3,0XDC,0XBD,0XBB,0XC2,0X7F,0X80,0X87,0XE3,0XEA,
0XEE,0XE1,0XE3,0XE5,0X09,0X07,0X06,0X0A,0X05,0X05,0X13,0X0A,0X08,0X67,0X5A,0X46,
0X73,0X65,0X54,0X28,0X1D,0X15,0XAA,0XA3,0X9A,0XA7,0XA1,0X8E,0XA1,0X9E,0X89,0XA5,
0XA2,0X8E,0XA6,0XA3,0X8E,0X9F,0X9C,0X88,0X9D,0X9C,0X89,0X8D,0X8E,0X7A,0X93,0X90,
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
0XFF,0XFF,0XFF,0XFF,0XFF,0XFF,0XFF,0XFF,0XFF,0XFF,0XFF,0XFF,0XFF,0XFF,0XFF,0XFF,
0XFF,0XFF,0XFF,0XFF,0XFF,0XFF,0XFF,0XFF,0XFF,0XFF,0XFF,0XFF,0XFF,0XFF,0XFF,0XFF,
0XFF,0XFF,0XFF,0XFF,0XFF,0XFF,0XFF,0XFF,0XFF,0XFF,0XFF,0XFF,0XFF,0XFF,0XFF,0XFF,

#endif
};
