ZouQiangBin/POV-LED/3-FIRMWARE/Project-MBI5353-SK9822/User/InterfaceCfg/PICTURE2.c

#include "main.h"

const Uint8 Pic2[RMAXX][RMAXY*3] = {
#if (DEVICE_SEL == 1)
0X94,0XA4,0X9B,0X95,0XA3,0XA0,0X98,0XA7,0XA3,0X98,0XA6,0XA5,0X97,0XA9,0XA3,0X9C,
0XAB,0XA6,0X9A,0XA7,0XA5,0X99,0XA4,0XA7,0X9A,0XA4,0XA6,0X9B,0XA8,0XA9,0XA2,0XB2,
0XB1,0XA8,0XBA,0XB4,0XAE,0XB8,0XBB,0XAF,0XBA,0XBC,0XAF,0XBC,0XBE,0XB1,0XBD,0XC4,
0XB1,0XBE,0XC1,0XB3,0XC1,0XC4,0XB6,0XC0,0XC9,0XB9,0XBE,0XCE,0XB4,0XC5,0XC8,0XB9,
0XC2,0XC8,0XBA,0XC5,0XCD,0XBE,0XC6,0XD0,0XC2,0XC5,0XCF,0XBD,0XC7,0XCE,0XBC,0XC8,
0XCE,0XC0,0XC6,0XD3,0XC0,0XCA,0XCE,0XC1,0XCA,0XD1,0XBF,0XC9,0XD2,0XBD,0XCC,0XCE,
0XBD,0XCD,0XCC,0XBF,0XC8,0XD2,0XBE,0XC8,0XCF,0XBD,0XCA,0XCA,0XBD,0XC8,0XCA,0XBE,
0XC5,0XCB,0XBF,0XC7,0XCA,0XBF,0XCA,0XCA,0XBD,0XC9,0XC6,0XC2,0XC7,0XCA,0XC0,0XC7,
0XCA,0XB9,0XC7,0XC5,0XBC,0XC2,0XC7,0XBC,0XC5,0XC3,0XBD,0XC1,0XC4,0XB5,0XC4,0XBB,
0X97,0XA4,0XA2,0X9C,0XA4,0XA3,0X9B,0XA4,0XA8,0X98,0XA7,0XA7,0X9C,0XAA,0XA6,0X9F,
0XAE,0XAA,0X9B,0XA8,0XA8,0X9A,0XA6,0XA8,0X9B,0XA5,0XA7,0X9F,0XA8,0XAA,0XA6,0XB5,
0XB6,0XA9,0XBB,0XBC,0XAF,0XB9,0XC0,0XB3,0XBC,0XC1,0XB3,0XBF,0XC1,0XB6,0XBE,0XC7,
0XB5,0XC0,0XCA,0XB8,0XBF,0XCD,0XB8,0XC3,0XCC,0XBA,0XC2,0XCE,0XB7,0XC5,0XCE,0XBD,
0XC3,0XCF,0XBD,0XC6,0XD0,0XBE,0XC8,0XD0,0XC1,0XC5,0XD3,0XBE,0XC9,0XD1,0XC2,0XC8,
0XD0,0XC1,0XCC,0XD2,0XC3,0XCC,0XD4,0XBF,0XCB,0XD4,0XBF,0XCD,0XD1,0XC1,0XCC,0XD0,
0XC2,0XCB,0XD1,0XC3,0XC8,0XD1,0XC5,0XC9,0XD1,0XC1,0XCB,0XD2,0XC8,0XC8,0XCF,0XC0,
0XC7,0XCC,0XC6,0XC9,0XCF,0XC4,0XCB,0XCB,0XC0,0XCA,0XCD,0XC1,0XC9,0XCD,0XBF,0XC7,
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
0XFA,0XFA,0XFA,0XFE,0XFE,0XFE,0XFB,0XFB,0XFB,0XFD,0XFD,0XFD,0XFD,0XFD,0XFD,0XF8,
0XF8,0XF8,0XFE,0XFE,0XFE,0XFD,0XFD,0XFD,0XFD,0XFD,0XFD,0XFD,0XFD,0XFD,0XFD,0XFD,
0XFD,0XFD,0XFD,0XFD,0XFD,0XFD,0XFD,0XFD,0XFD,0XFD,0XFD,0XFD,0XFD,0XFD,0XFD,0XFD,
#endif
};
