ZouQiangBin/POV-LED/3-FIRMWARE/Project-MBI5353-SK9822/User/InterfaceCfg/PICTURE3.c

#include "main.h"

const Uint8 Pic3[RMAXX][RMAXY*3] = {
#if (DEVICE_SEL == 1)
0XEB,0XD6,0XD1,0XFF,0XF7,0XF4,0XCF,0XB8,0XB0,0XC3,0XAD,0XA2,0X8E,0X77,0X6F,0X5C,
0X4A,0X46,0X60,0X51,0X4A,0X59,0X48,0X40,0X95,0X7A,0X65,0XAD,0X92,0X75,0XAC,0X8F,
0X71,0XB4,0X9A,0X79,0XB4,0X97,0X77,0XB8,0X99,0X7A,0XBA,0X9D,0X7F,0XBA,0X9D,0X7D,
0XBE,0XA1,0X81,0XBD,0X9E,0X7F,0XC2,0XA3,0X84,0XC1,0XA4,0X84,0XC6,0XA7,0X88,0XD5,
0XB8,0X96,0XCB,0XAE,0X8E,0XD8,0XBB,0X99,0XDB,0XC1,0XA0,0XFE,0XFA,0XDF,0XCE,0XBF,
0XAC,0XD0,0XBF,0XAD,0XCB,0XBB,0XAC,0XCF,0XBF,0XB0,0XCE,0XBF,0XAA,0XD0,0XBF,0XAB,
0XD3,0XC2,0XB2,0XDB,0XCA,0XBA,0XD9,0XC8,0XB8,0XD7,0XC8,0XB5,0XDE,0XCD,0XBD,0XD7,
0XC6,0XB6,0XD6,0XC5,0XB5,0XD4,0XC3,0XB1,0XCE,0XBC,0XA8,0XC1,0XAF,0X9B,0XB8,0XA5,
0X94,0XFF,0XFC,0XF0,0X9C,0X8B,0X7B,0X43,0X36,0X2D,0X6E,0X5D,0X4D,0X67,0X55,0X3F,
0XA6,0X8C,0X7D,0X67,0X51,0X43,0X5A,0X46,0X3B,0X52,0X41,0X39,0X3C,0X2E,0X25,0X43,
0X36,0X30,0X46,0X39,0X31,0X3F,0X32,0X2C,0X36,0X2B,0X25,0X43,0X36,0X2E,0X40,0X33,
0X2A,0X71,0X60,0X50,0X9D,0X82,0X65,0XAF,0X92,0X72,0XAC,0X8F,0X71,0XB0,0X93,0X73,
0XB4,0X97,0X77,0XB6,0X99,0X79,0XBD,0X9E,0X7F,0XBC,0X9F,0X81,0XBD,0XA0,0X82,0XC5,
0XA8,0X8A,0XC8,0XAB,0X8D,0XCB,0XAE,0X8E,0XD7,0XBD,0X9C,0XFB,0XF5,0XDD,0XD3,0XC6,
0XB6,0XD7,0XCA,0XBA,0XD8,0XC8,0XB8,0XD7,0XCA,0XBA,0XDB,0XCB,0XBB,0XDE,0XCF,0XBC,
0XDC,0XCC,0XBC,0XD9,0XC9,0XB9,0XD8,0XC8,0XB8,0XDD,0XCC,0XBC,0XDA,0XC9,0XB9,0XD9,
0XC6,0XB5,0XD5,0XC2,0XB1,0XD0,0XBE,0XAA,0XCB,0XB6,0XA3,0XBF,0XAC,0X9B,0XBB,0XA8,
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
0X1E,0X58,0X6C,0X07,0X41,0X55,0X0D,0X47,0X5D,0X0C,0X46,0X5C,0X0F,0X4C,0X61,0X0E,
0X4B,0X60,0X1A,0X58,0X6D,0X1C,0X5A,0X71,0X0D,0X4D,0X68,0X13,0X54,0X70,0X15,0X58,
0X73,0X13,0X59,0X73,0X0D,0X50,0X6B,0X10,0X51,0X6D,0X0F,0X4C,0X68,0X0E,0X47,0X64,
0X11,0X49,0X64,0X16,0X4E,0X69,0X15,0X4F,0X67,0X0F,0X49,0X5F,0X0A,0X44,0X58,0X0E,
0X47,0X5B,0X10,0X44,0X5A,0X0E,0X3C,0X53,0X0D,0X36,0X48,0X06,0X29,0X3C,0X0D,0X2E,
0X41,0X0A,0X29,0X3D,0X17,0X3A,0X4E,0X14,0X38,0X46,0X0B,0X31,0X34,0X34,0X58,0X4E,
0X46,0X66,0X4E,0X30,0X49,0X34,0X4E,0X60,0X62,0XE2,0XE9,0XF9,0XD6,0XD5,0XE7,0XCF,
0XCA,0XE0,0XC5,0XC6,0XDA,0XC3,0XC6,0XD9,0X0E,0X48,0X5C,0X0D,0X47,0X5B,0X10,0X4A,
0X60,0X13,0X4D,0X63,0X0C,0X49,0X5E,0X2B,0X68,0X7D,0X33,0X71,0X86,0X1C,0X5A,0X71,
0X17,0X57,0X72,0X12,0X53,0X6F,0X0D,0X50,0X6B,0X0D,0X53,0X6D,0X10,0X53,0X6E,0X0E,
0X4F,0X6B,0X0C,0X49,0X65,0X0A,0X46,0X62,0X0E,0X47,0X62,0X10,0X49,0X64,0X11,0X4D,
0X65,0X0D,0X4A,0X5F,0X09,0X43,0X57,0X0C,0X45,0X59,0X11,0X45,0X5B,0X0F,0X3D,0X54,
0X0B,0X34,0X46,0X0A,0X2D,0X40,0X09,0X29,0X3E,0X10,0X31,0X44,0X1A,0X3E,0X4E,0X12,
0X38,0X45,0X0E,0X33,0X3C,0X28,0X4A,0X49,0X3E,0X5E,0X47,0X5F,0X78,0X62,0XDD,0XED,
0XEC,0XCB,0XD3,0XDE,0XCA,0XC7,0XD8,0XD3,0XCE,0XE2,0XC5,0XC6,0XDA,0XBD,0XC0,0XD3,


#endif
};
