ZouQiangBin/POV-LED/3-FIRMWARE/Project-IS31FL3236/User/MUSIC.c

#define L_DO	262
#define L_DO1	277
#define L_RE	294
#define L_RE2	311
#define L_MI	330
#define L_FA	349
#define L_FA4	370
#define L_SO	392
#define L_SO5	415
#define L_LA	440
#define L_LA6	466
#define L_SI	494

#define M_DO	262*2
#define M_DO1	277*2
#define M_RE	294*2
#define M_RE2	311*2
#define M_MI	330*2
#define M_FA	349*2
#define M_FA4	370*2
#define M_SO	392*2
#define M_SO5	415*2
#define M_LA	440*2
#define M_LA6	466*2
#define M_SI	494*2

#define H_DO	262*4
#define H_DO1	277*4
#define H_RE	294*4
#define H_RE2	311*4
#define H_MI	330*4
#define H_FA	349*4
#define H_FA4	370*4
#define H_SO	392*4
#define H_SO5	415*4
#define H_LA	440*4
#define H_LA6	466*4
#define H_SI	494*4
