ZouQiangBin/POV-LED/(commit log)

2022-04-04 项目文件提交
    提交软件工程、APP项目及APK文件，参考文献以及部分图片
2022-04-04 图片赚C51数组工具
2022-04-04 数据手册和BOM文件提交
    [1-LED-A-SCH-MBI5353.xlsx, 2-LED-B-SCH-SK9822.xlsx, 3-LED-C-SCH.xlsx, 4-结构件.xlsx, ECB01-Kit-001.PcbDoc, ECB01-Kit-002.PcbDoc, ECB01-Kit-003.PcbDoc, ECB01-Kit-004.PcbDoc]
2022-04-04 原理图、PCB和3D建模
    [LED-A-PCB-IS31FL3236.pcb, LED-A-PCB-MBI5353.pcb, LED-A-SCH-IS31FL3236.sch, LED-A-SCH-MBI5353-新修改未设计.sch, LED-A-SCH-MBI5353.sch, LED-B-PCB-IS31FL3236.pcb, LED-B-PCB-MBI5353.pcb, LED-B-PCB-SK9822.pcb]
2022-04-11 关于设计文件打开说明
2022-04-15 画面抖动优化
    优化画面抖动问题，已有较大改善，同时在图片功能增加太阳显示，亮度自定义调节
2022-04-29 更新项目教程
    详细介绍了《POV LED》的设计过程
